Hornet-7-Comms/sauvc2022-acoustics/Firmware/stm32h750_acoustics/Docs/Clock Tree.png

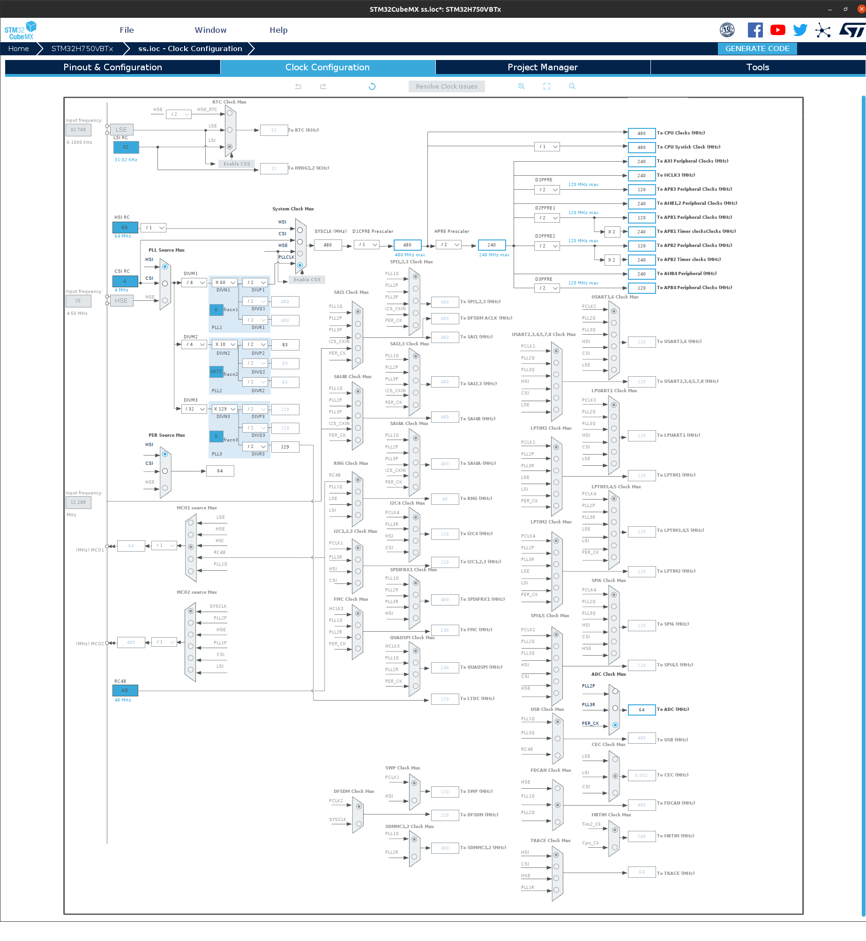
Firmware/stm32h750_acoustics/Docs/Clock Tree.png
