Hornet-7-Comms/sauvc2022-acoustics/Firmware/stm32h750_acoustics/Docs/Pinout.jpeg

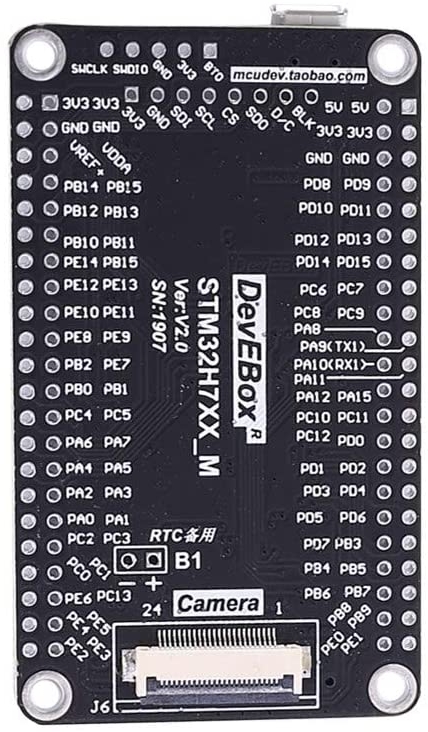
Firmware/stm32h750_acoustics/Docs/Pinout.jpeg
