Hornet-7-Comms/sauvc2022-acoustics/PCB/Acoustics ShopCart.xlsx

Qty | Mfr Part No | Unit Price (excl GST) | Line Price (excl GST) | Description | element14 link
50 | MC0805B104K250CT | 0.02 | 1 | 100nF C0805 | https://sg.element14.com/multicomp/mc0805b104k250ct/cap-0-1-f-25v-10-x7r-0805/dp/1759166 | x
50 | CL21B103KBANNNC | 0.054 | 2.7 | 10nF C0805 | https://sg.element14.com/samsung-electro-mechanics/cl21b103kbannnc/cap-0-01uf-50v-mlcc-0805/dp/3013470 | x
100 | MC0805B102K500CT | 0.027 | 2.7 | 1nF C0805 | https://sg.element14.com/multicomp/mc0805b102k500ct/cap-1000pf-50v-10-x7r-0805/dp/1759226 | x
40 | MCWR08X1503FTL | 0.006 | 0.24 | 150k R0805 | https://sg.element14.com/multicomp/mcwr08x1503ftl/res-150k-1-0-125w-thick-film/dp/2447573 | z | 0
50 | MCMR08X153 JTL | 0.008 | 0.4 | 15k R0805 | https://sg.element14.com/multicomp/mcmr08x153-jtl/res-15k-5-0-125w-0805-ceramic/dp/2073649 | z | 0
40 | MC01W080511K5 | 0.004 | 0.16 | 1k5 R0805 | https://sg.element14.com/multicomp/mc01w080511k5/res-1k5-1-0-1w-0805-thick-film/dp/9332600 |  | 0
40 | MCWR08X2200FTL | 0.006 | 0.24 | 220 R0805 | https://sg.element14.com/multicomp/mcwr08x2200ftl/res-220r-1-0-125w-0805-thick-film/dp/2447606 | y
50 | MCWR08X2201FTL | 0.006 | 0.3 | 2k2 R0805 | https://sg.element14.com/multicomp/mcwr08x2201ftl/res-2k2-1-0-125w-0805-thick-film/dp/2447623 | y
20 | MCMR08X8201FTL | 0.01 | 0.2 | 8k2 R0805 | https://sg.element14.com/multicomp/mcmr08x8201ftl/res-8k2-1-0-125w-0805-ceramic/dp/2073849 | z | 0
20 | MCWR08X4701FTL | 0.006 | 0.12 | 4k7 R0805 | https://sg.element14.com/multicomp/mcwr08x4701ftl/res-4k7-1-0-125w-0805-thick-film/dp/2447672 | y
50 | MCWR08X1001FTL | 0.006 | 0.3 | 1k R0805 | https://sg.element14.com/multicomp/mcwr08x1001ftl/res-1k-1-0-125w-0805-thick-film/dp/2447587 | y | 0
5 | BZV55-B5V1,115 | 0.282 | 1.41 | 5V1 Zener Mini-MELF | https://sg.element14.com/nexperia/bzv55-b5v1-115/diode-zener-5-1v-2-sod-80/dp/8735441 | y
20 | LL4148-7 | 0.025 | 0.5 | Signal diode Mini-MELF | https://sg.element14.com/multicomp/ll4148-13/diode-ultrafast-recovery-75v-minimelf/dp/2306145
 |  |  | Goods Total (excl GST)
 |  |  | 10.27
