Hornet-7-Comms/sauvc2022-acoustics/Firmware/teensy_sketch_dec09b/Teensy Sch/parts_placement_teensy36_top.png

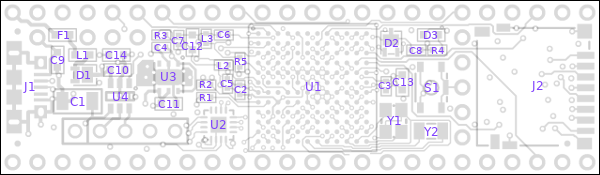
Firmware/teensy_sketch_dec09b/Teensy Sch/parts_placement_teensy36_top.png
