Hornet-7-Comms/sauvc2022-acoustics/PCB/Acoustics Soldering Guide.pptx

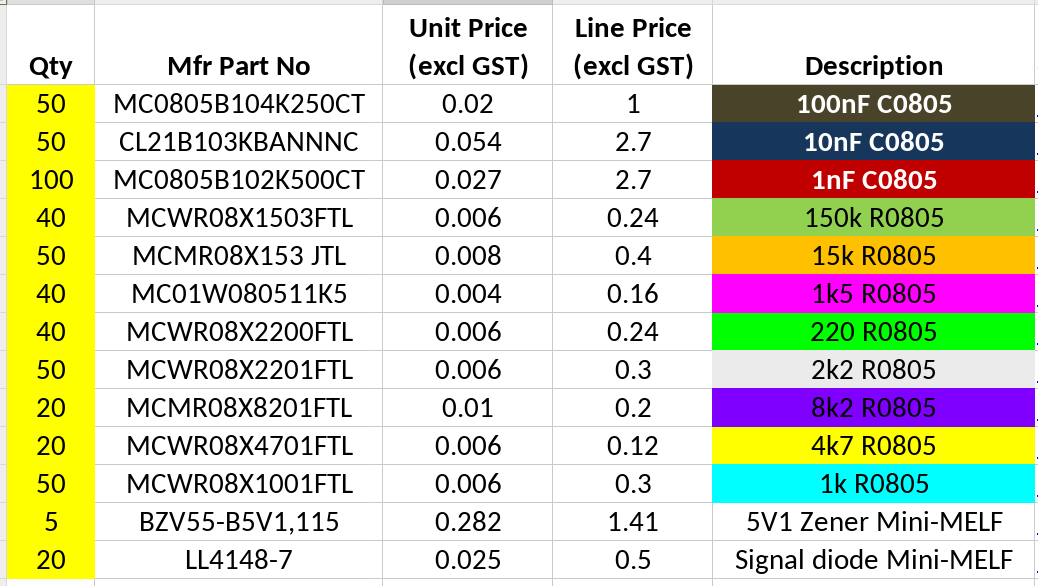
[picture p8: figure]

## Slide 2

100n

10n

1n

?

100n

10n

1n

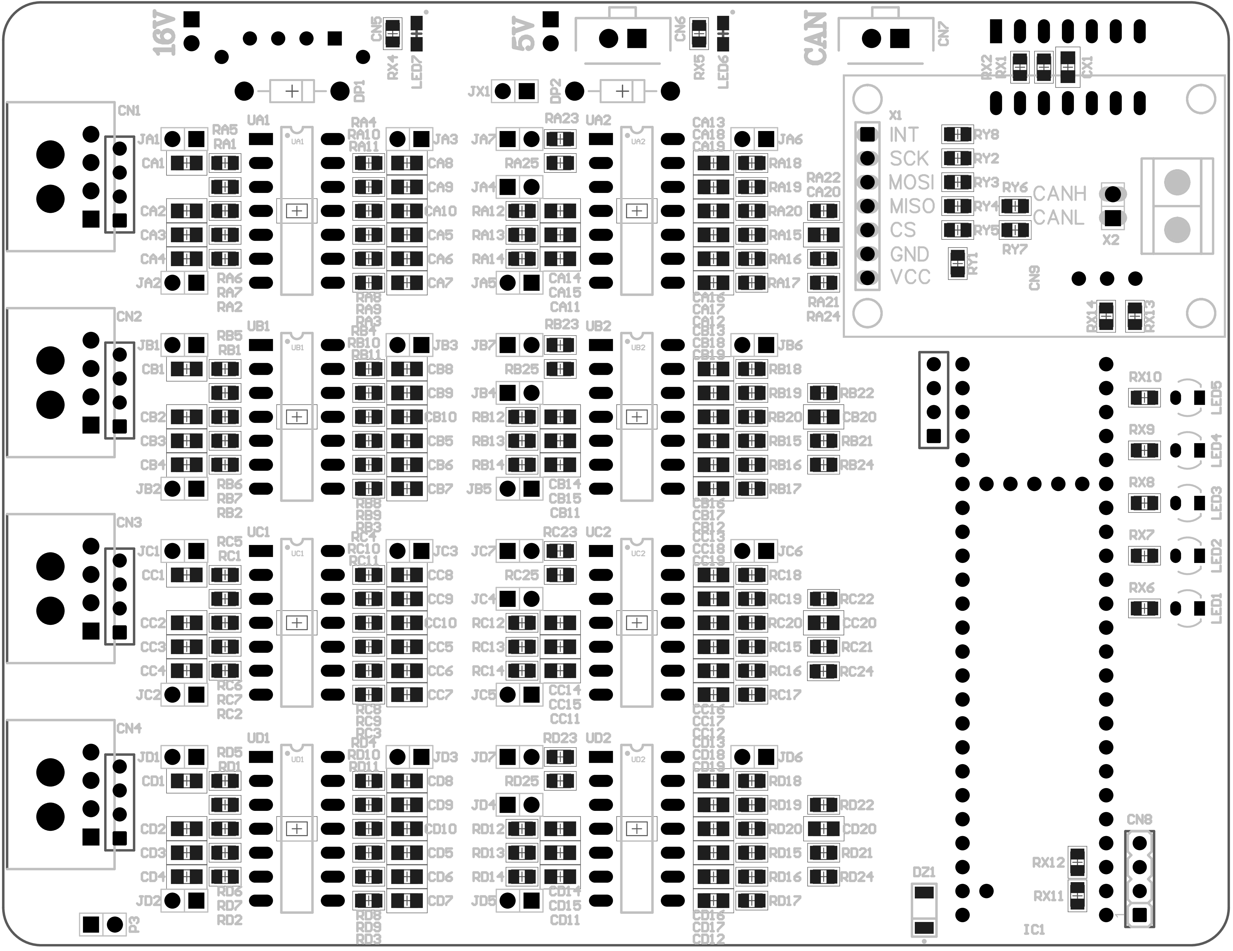
[picture p9: figure]

4k7

1k

150k

150k

100n

100n

150k

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
150k

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
100n

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
150k

150k

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
## Slide 3

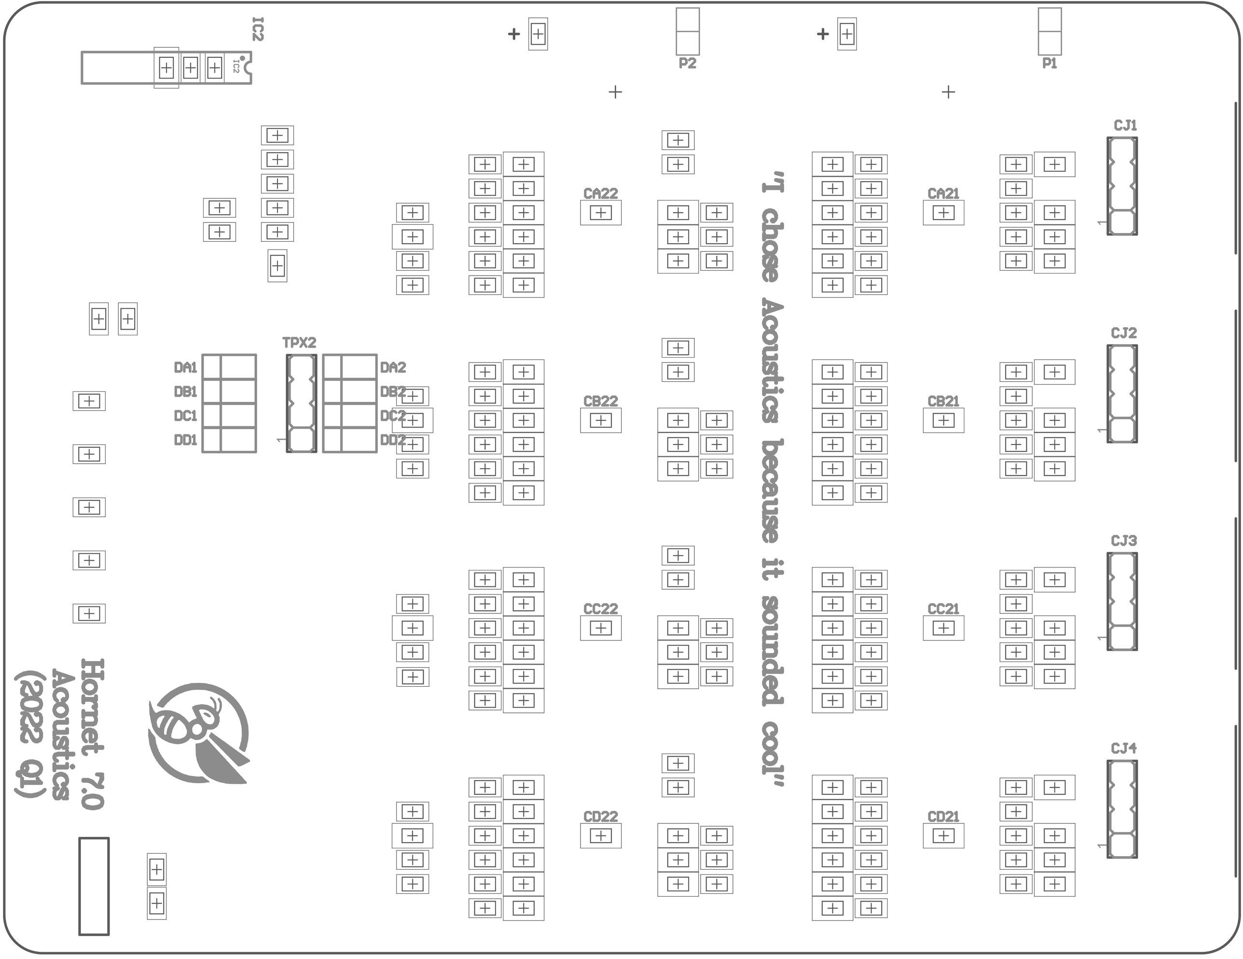
[picture p10: figure]

100n

100n

Z

Z
