Hornet-7-Comms/sauvc2022-acoustics/PCB/Acoustics Schematic.pdf

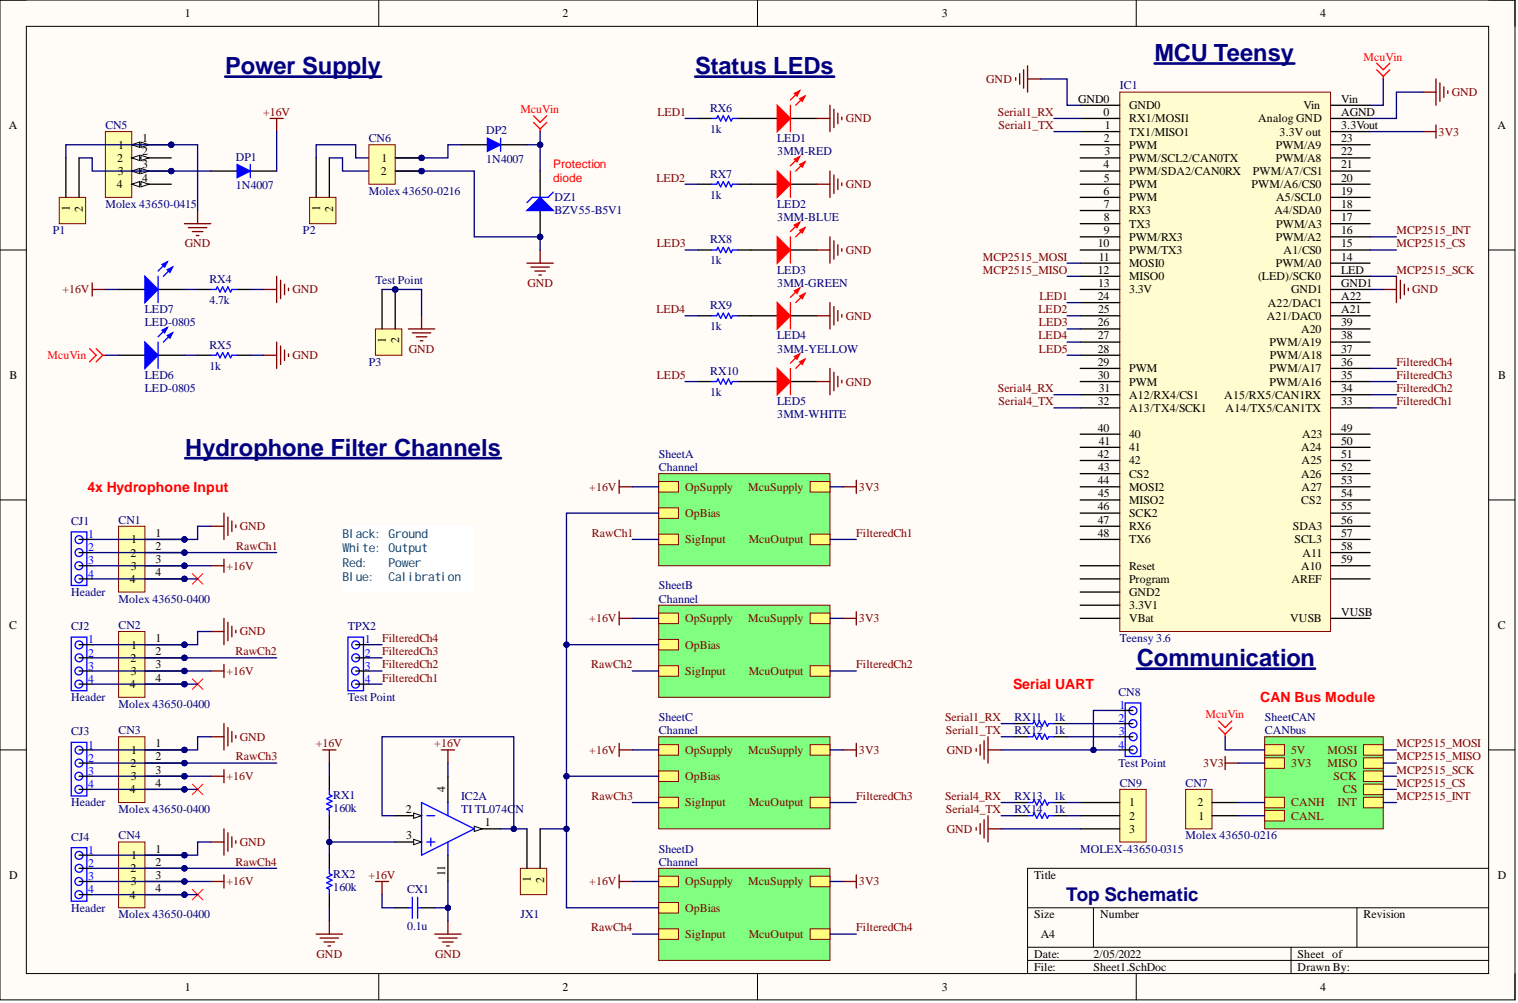
[picture p11: page 1]
4 PWM/A16; 35 PWM/A17; 36 PWM/A18; 37 PWM/A19; 39 A21/DAC0; 1 (LED)/SCK0; LED PWM/A0; 15 PWM/A2; 16 PWM/A3; 17 A4/SDA0; 18 A5/SCL0; 19 PWM/A6/CS0; 20 PWM/A7/CS1; 21 PWM/A8; 22 PWM/A9; 23 3.3V out; 3.3Vou; IC1 Teen; Power Supply; diode DZ1; Top Schematic; Status LEDs; CAN Bus M; Serial UART

Hydrophone Filter Channels

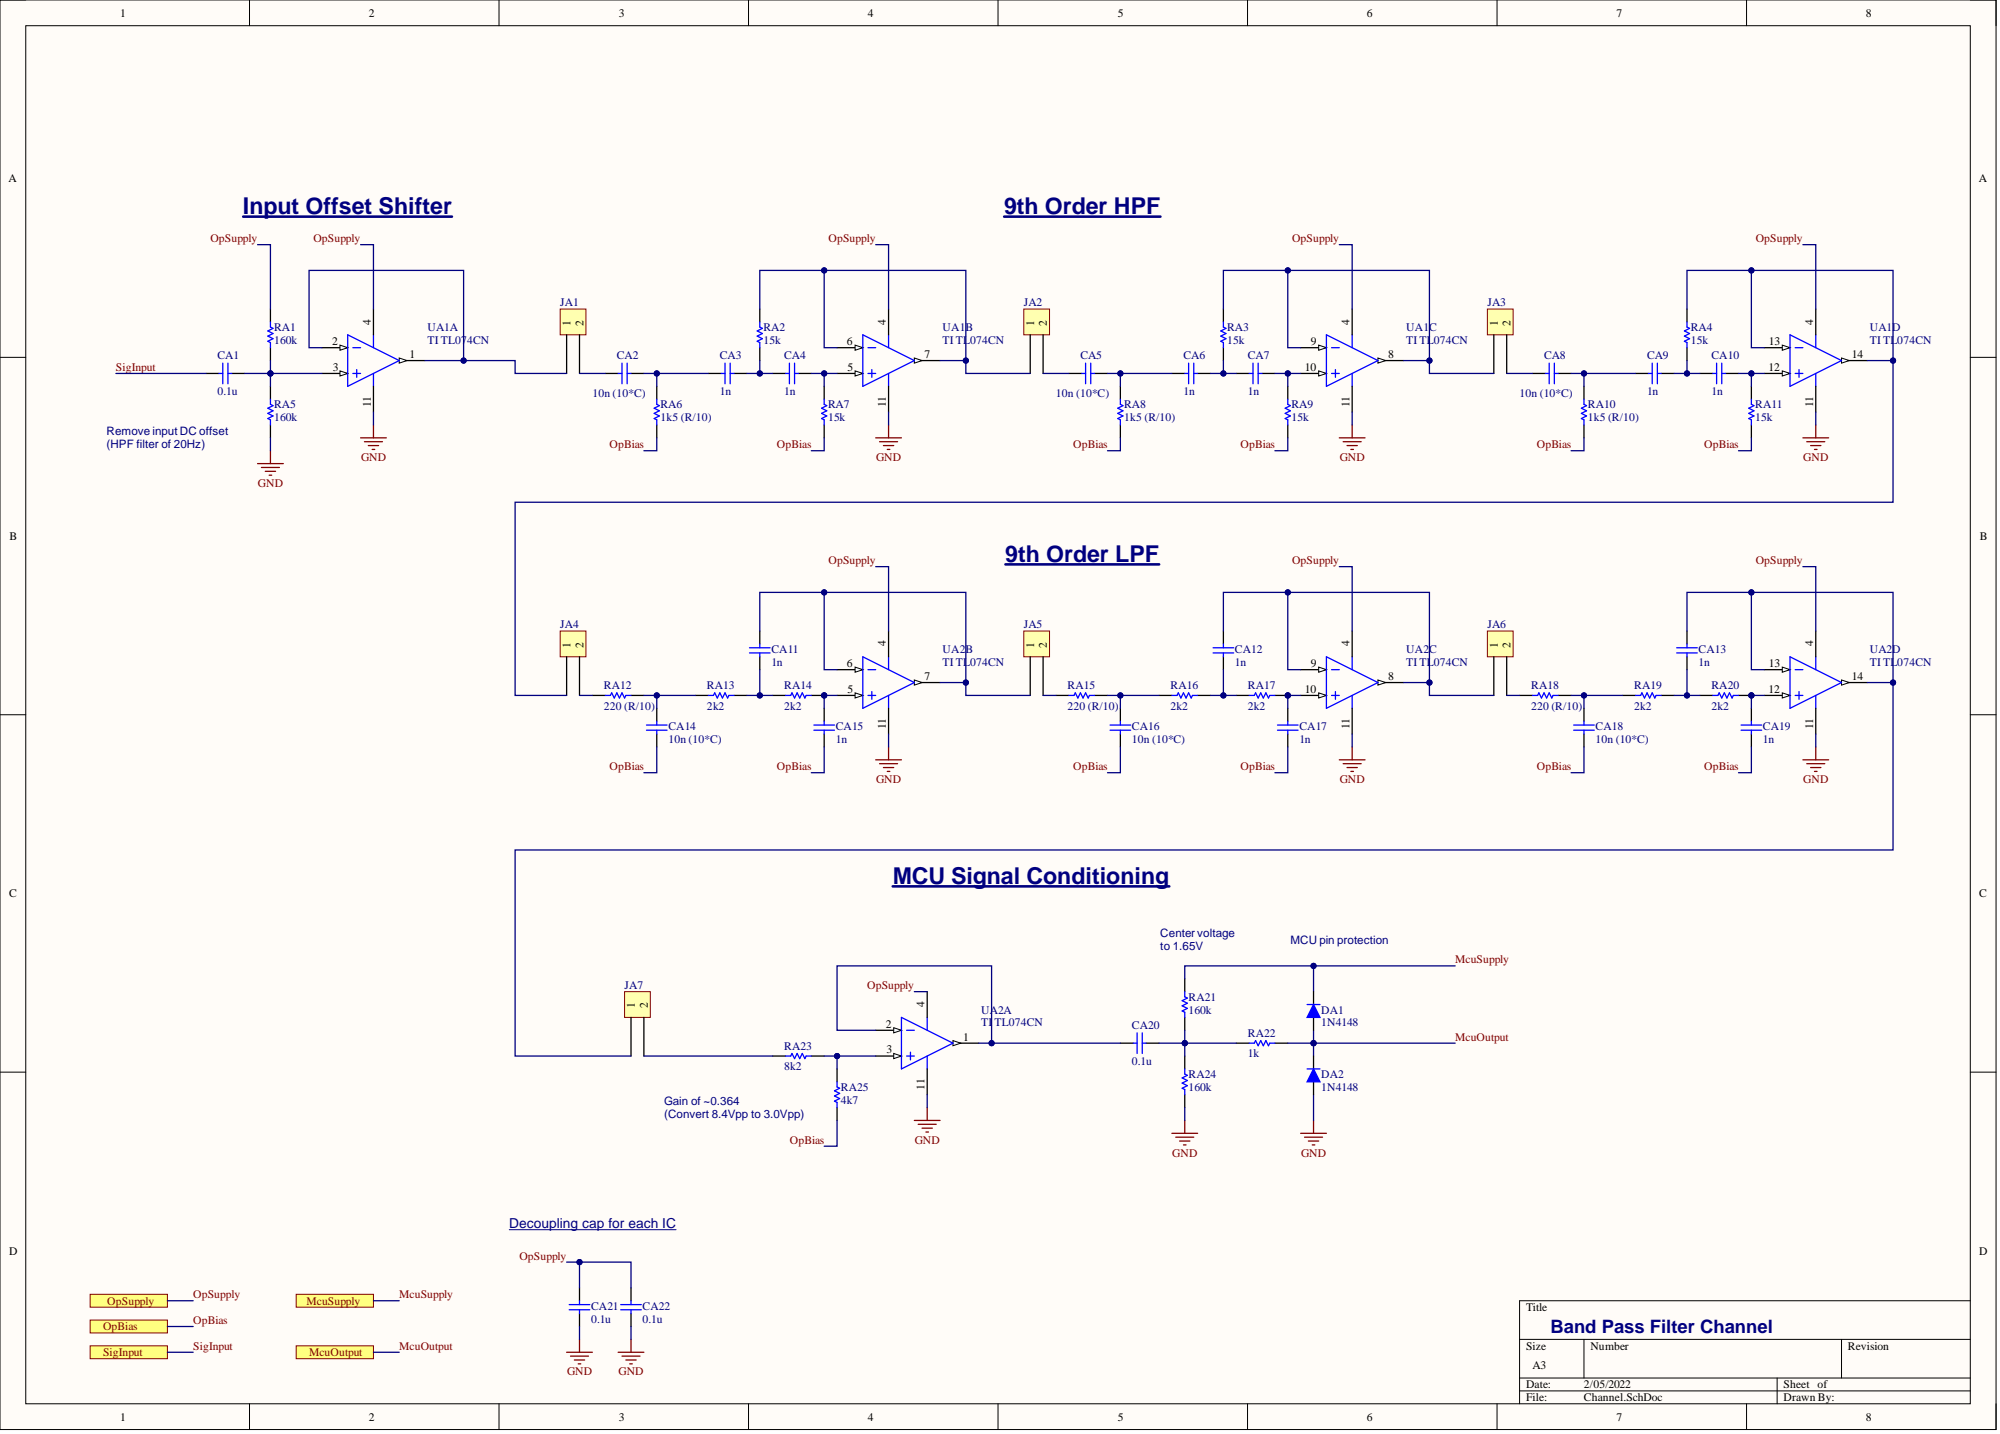
[picture p12: page 2]
Date:; Sheet of; File:; Channel.SchDoc; Drawn By:; 9th Order HPF; 9th Order LPF; Gain of ~0.364 (Convert 8.4Vpp to 3.0Vpp); Center voltage; MCU pin protection; PICA1402 COC14; PICA1502 COC15; PICA1602 COC16; PICA1702 COC17; PICA1802 COC18; PICA1902 COC19; PIDA10K COD1; PIDA20K COD2; PIJA101 PIJA102; PIJA201 PIJA202; PIJA301 PIJA302; PIJA401 PIJA402; PIJA501 PIJA502; PIJA601 PIJA602; PIJA701 PIJA702; PIRA102 COR1; PIRA202 COR2; PIRA302 COR3; PIRA402 COR4; PIRA502 COR5; PIRA602 COR6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

Input Offset Shifter

Remove input DC offset
(HPF filter of 20Hz)

MCU Signal Conditioning

Decoupling cap for each IC

Title
Band Pass Filter Channel

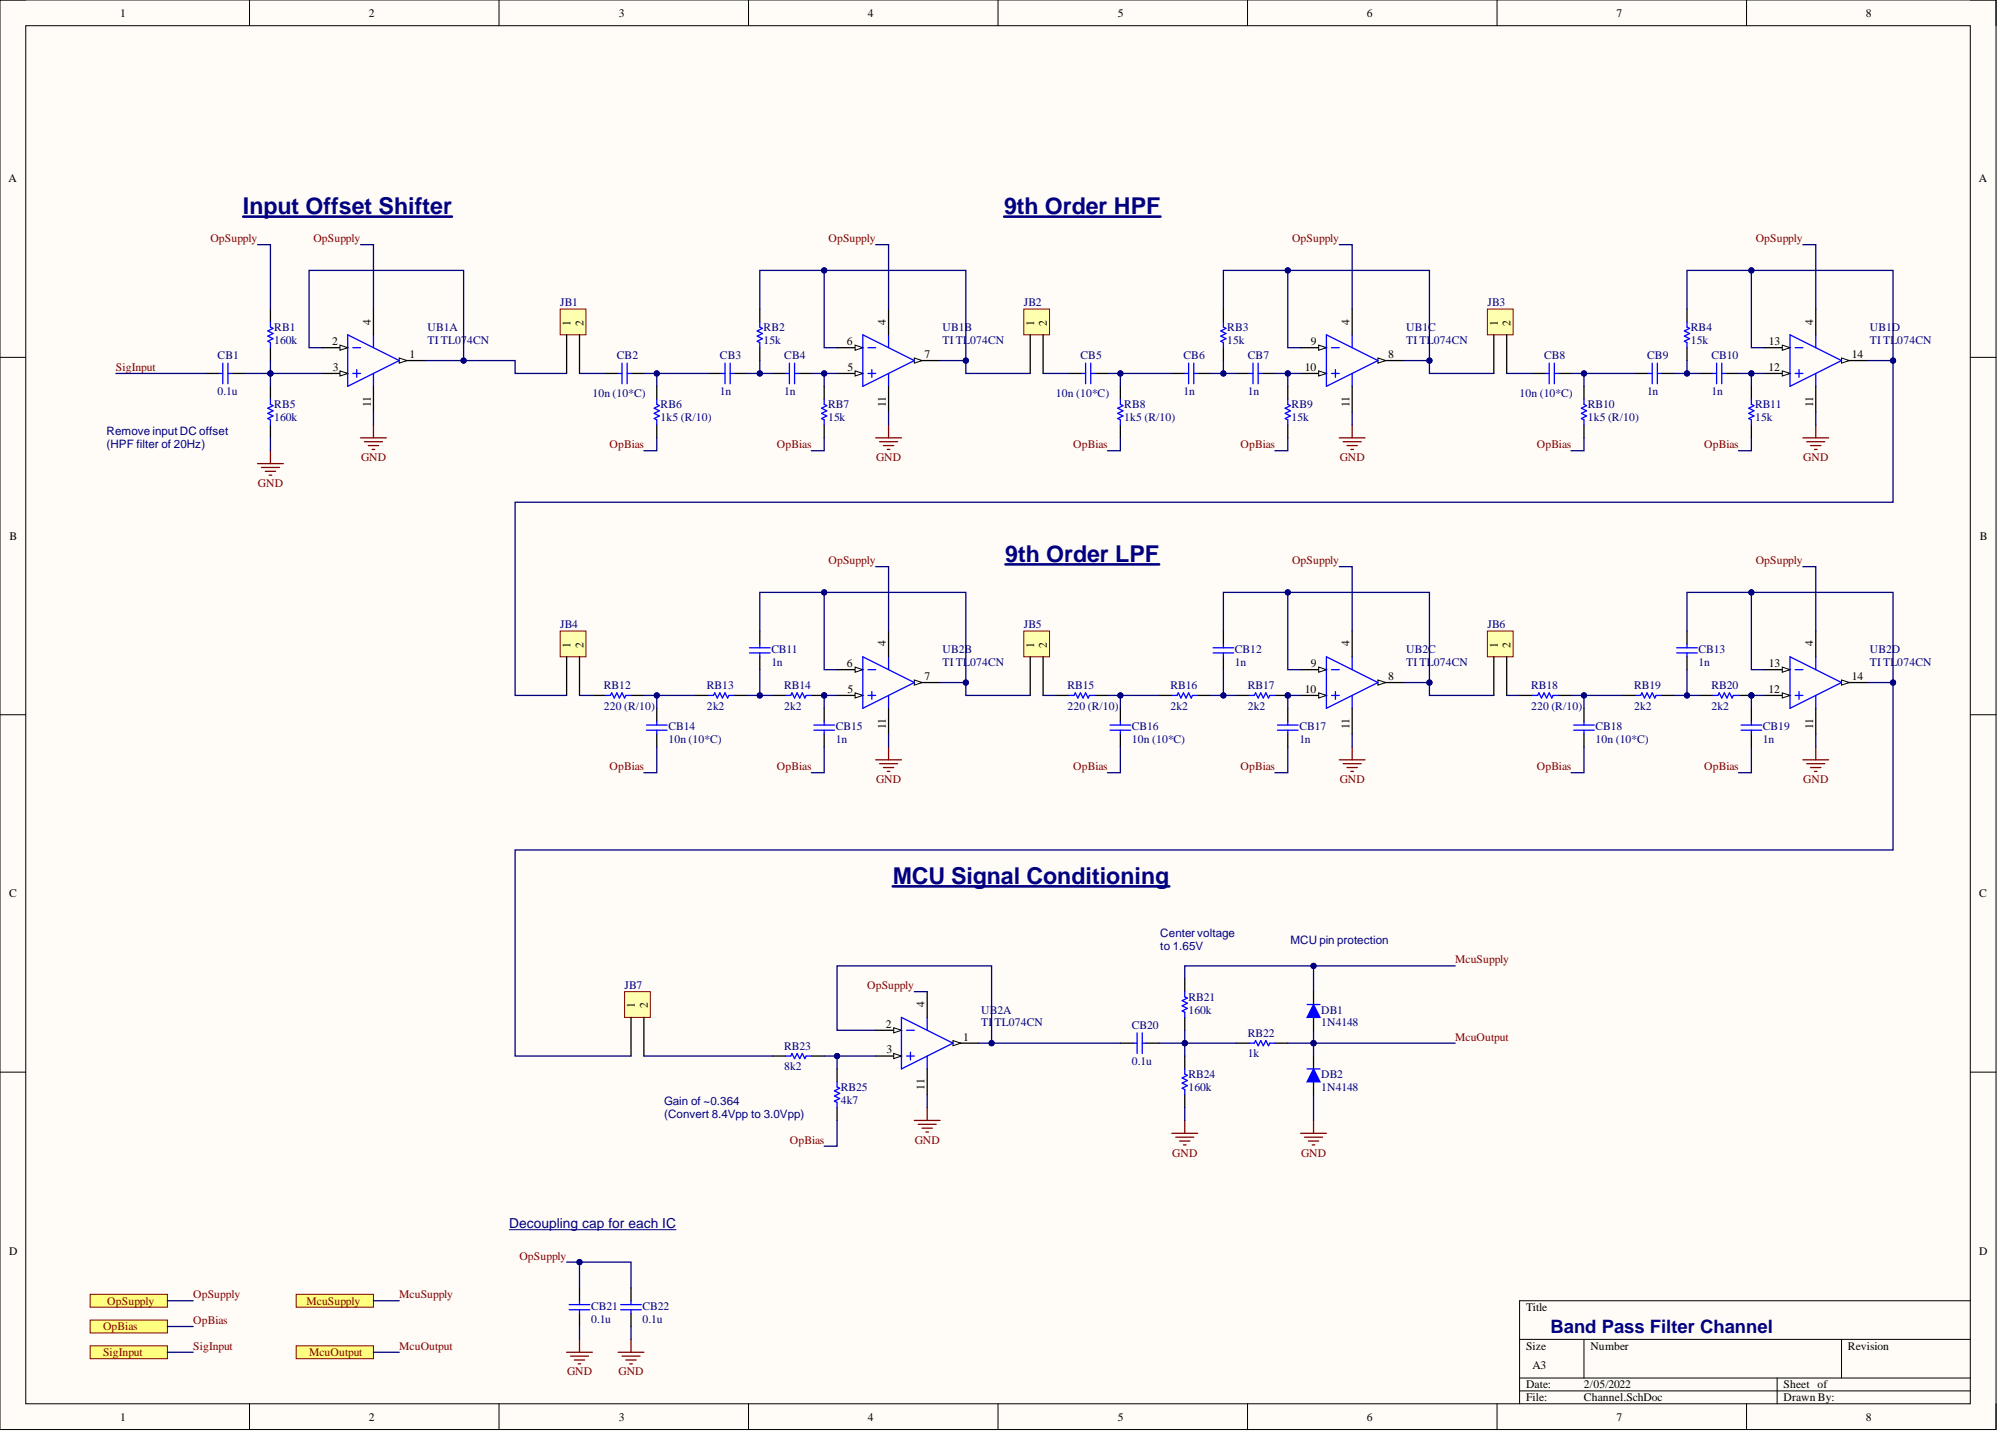
[picture p13: page 3]
9th Order HPF; 9th Order LPF; Gain of ~0.364 (Convert 8.4Vpp to 3.0Vpp); Center voltage; MCU pin protection; PICB1402 COC14; PICB1502 COC15; PICB1602 COC16; PICB1702 COC17; PICB1802 COC18; PICB1902 COC19; PIDB10K COD1; PIDB20K COD2; PIJB101 PIJB102; PIJB201 PIJB202; PIJB301 PIJB302; PIJB401 PIJB402; PIJB501 PIJB502; PIJB601 PIJB602; PIJB701 PIJB702; PIRB102 COR1; PIRB202 COR2; PIRB302 COR3; PIRB402 COR4; PIRB502 COR5; PIRB602 COR6; PIRB702 COR7; PIRB802 COR8; PIRB902 COR9; PIRB1002 COR10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

Input Offset Shifter

Remove input DC offset
(HPF filter of 20Hz)

MCU Signal Conditioning

Decoupling cap for each IC

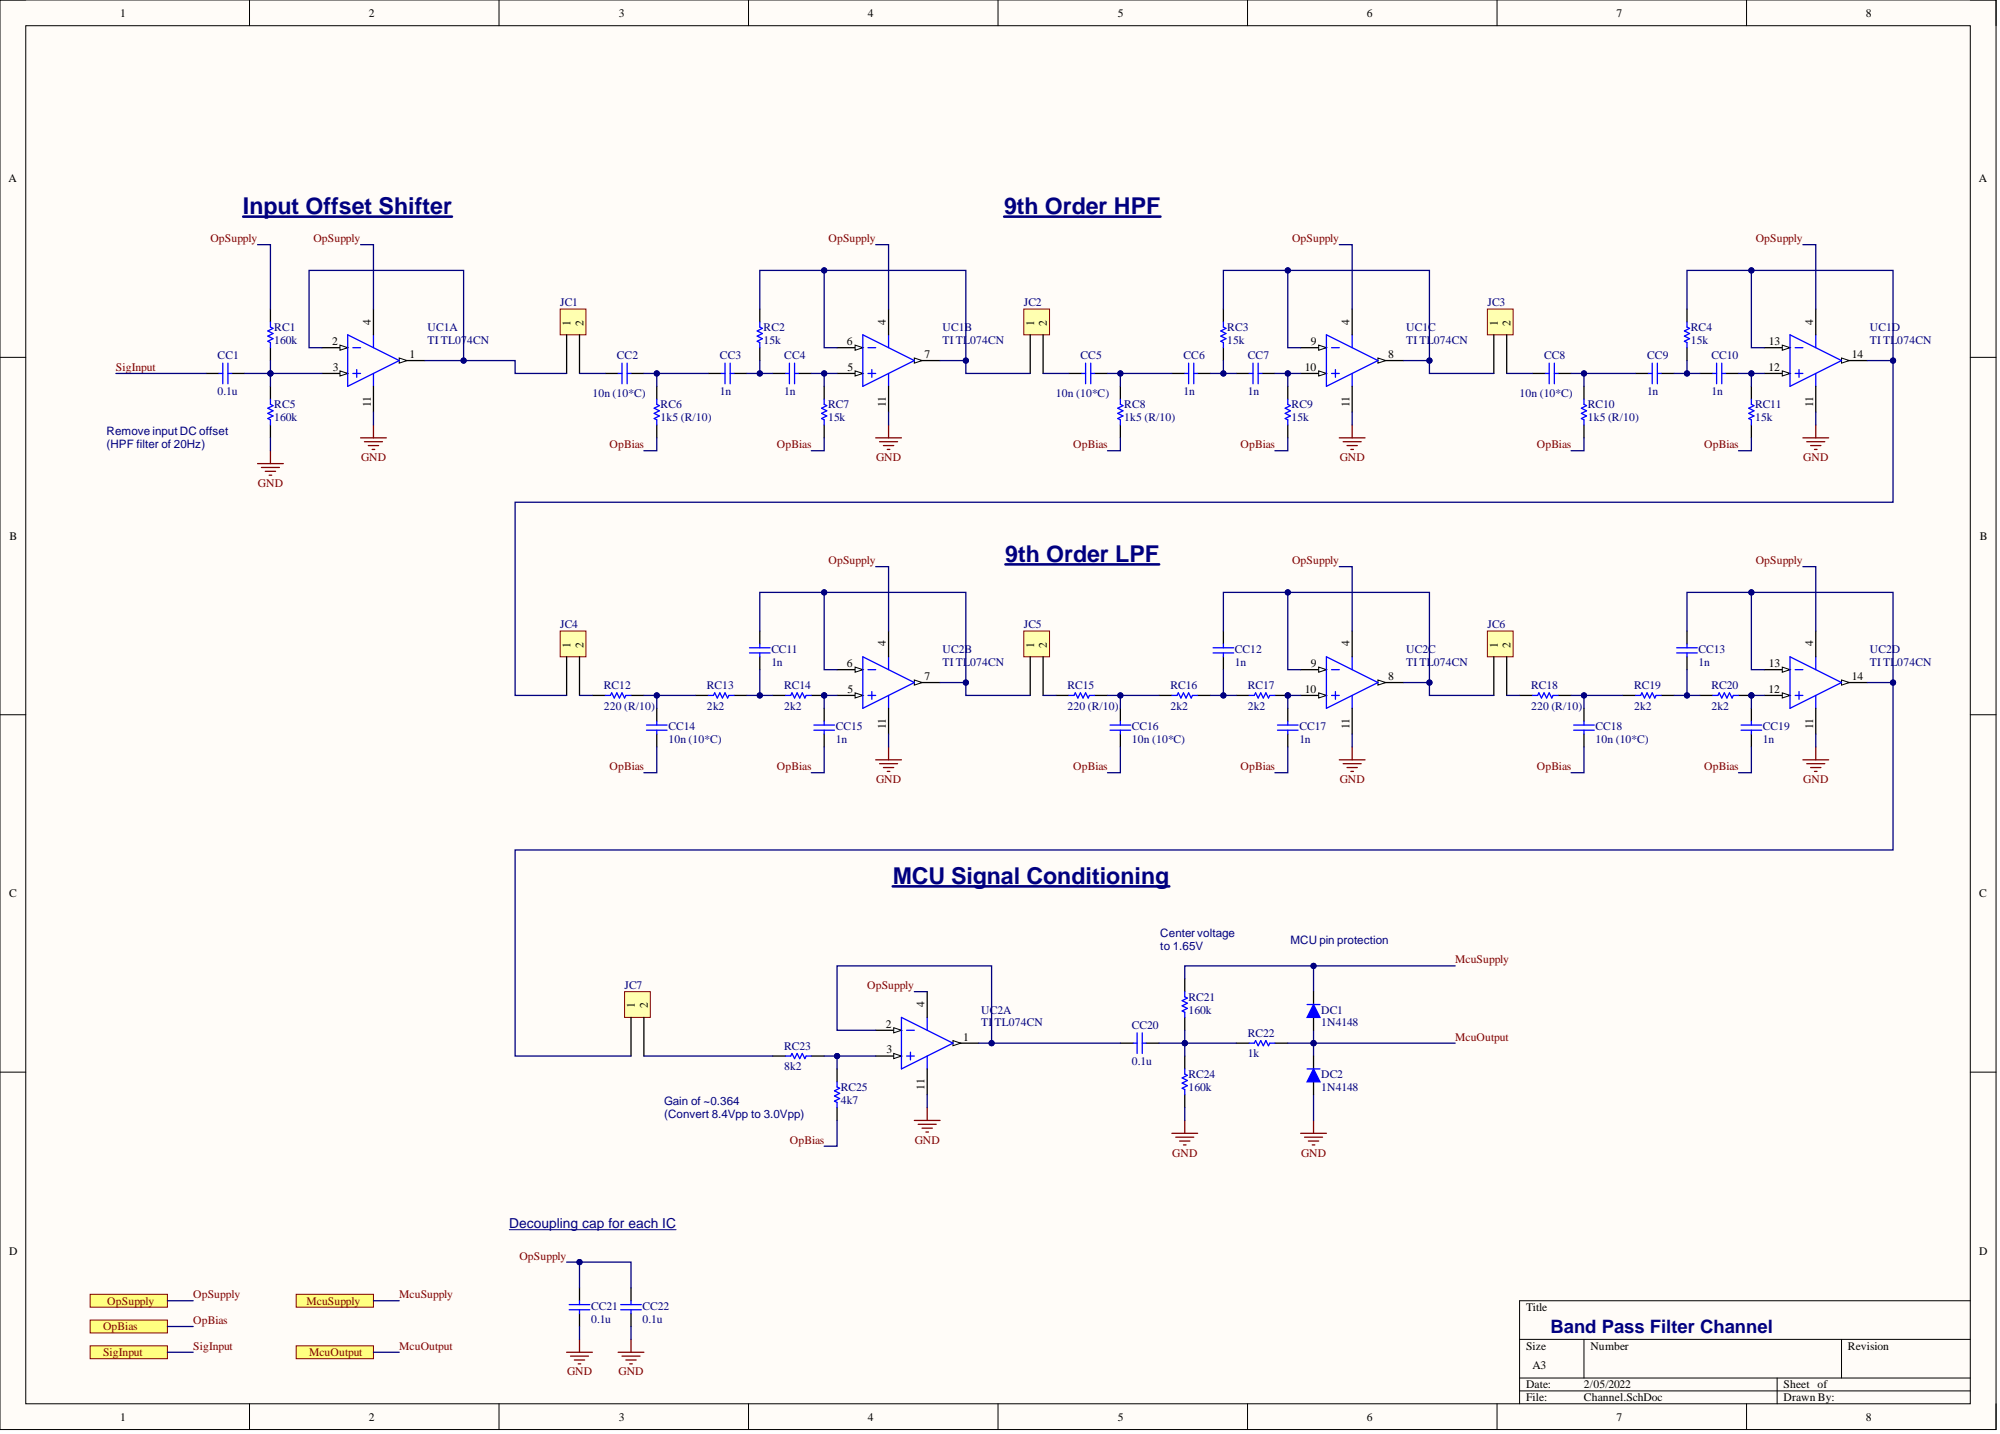
[picture p14: page 4]
9th Order HPF; 9th Order LPF; Gain of ~0.364 (Convert 8.4Vpp to 3.0Vpp); Center voltage; MCU pin protection; PICC1402 COC14; PICC1502 COC15; PICC1602 COC16; PICC1702 COC17; PICC1802 COC18; PICC1902 COC19; PIDC10K COD1; PIDC20K COD2; PIJC101 PIJC102; PIJC201 PIJC202; PIJC301 PIJC302; PIJC401 PIJC402; PIJC501 PIJC502; PIJC601 PIJC602; PIJC701 PIJC702; PIRC102 COR1; PIRC202 COR2; PIRC302 COR3; PIRC402 COR4; PIRC502 COR5; PIRC602 COR6; PIRC702 COR7; PIRC802 COR8; PIRC902 COR9; PIRC1002 COR10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

Input Offset Shifter

Remove input DC offset
(HPF filter of 20Hz)

MCU Signal Conditioning

Decoupling cap for each IC

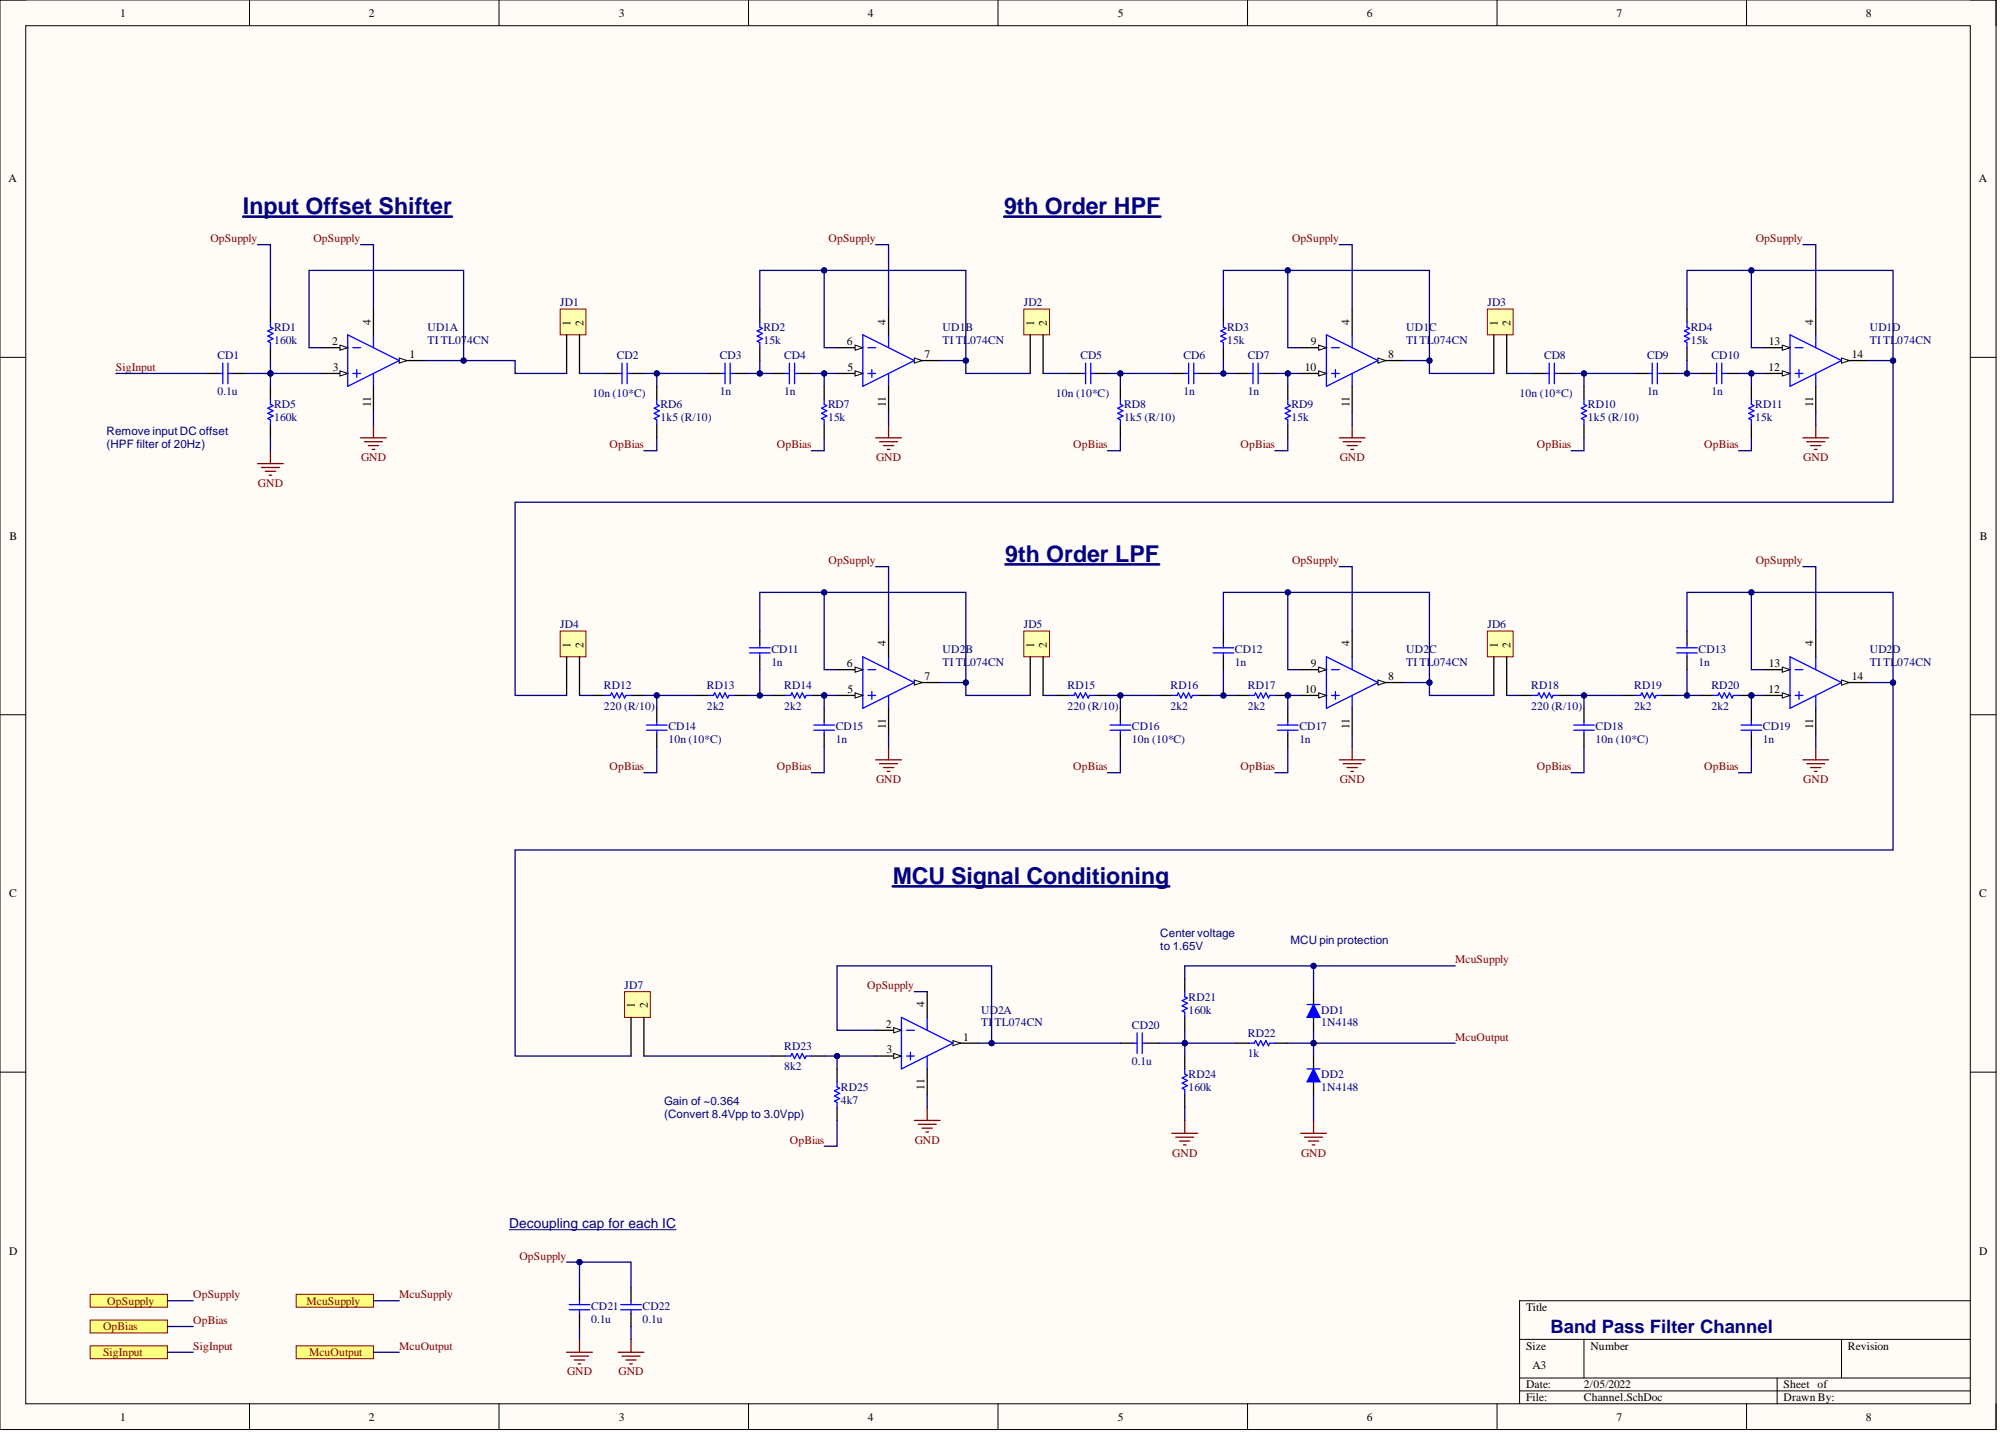
[picture p15: page 5]
9th Order HPF; 9th Order LPF; Gain of ~0.364 (Convert 8.4Vpp to 3.0Vpp); Center voltage; MCU pin protection; PICD1402 COC14; PICD1502 COC15; PICD1602 COC16; PICD1702 COC17; PICD1802 COC18; PICD1902 COC19; PIDD10K COD1; PIDD20K COD2; PIJD101 PIJD102; PIJD201 PIJD202; PIJD301 PIJD302; PIJD401 PIJD402; PIJD501 PIJD502; PIJD601 PIJD602; PIJD701 PIJD702; PIRD102 COR1; PIRD202 COR2; PIRD302 COR3; PIRD402 COR4; PIRD502 COR5; PIRD602 COR6; PIRD702 COR7; PIRD802 COR8; PIRD902 COR9; PIRD1002 COR10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

Input Offset Shifter

Remove input DC offset
(HPF filter of 20Hz)

MCU Signal Conditioning

Decoupling cap for each IC

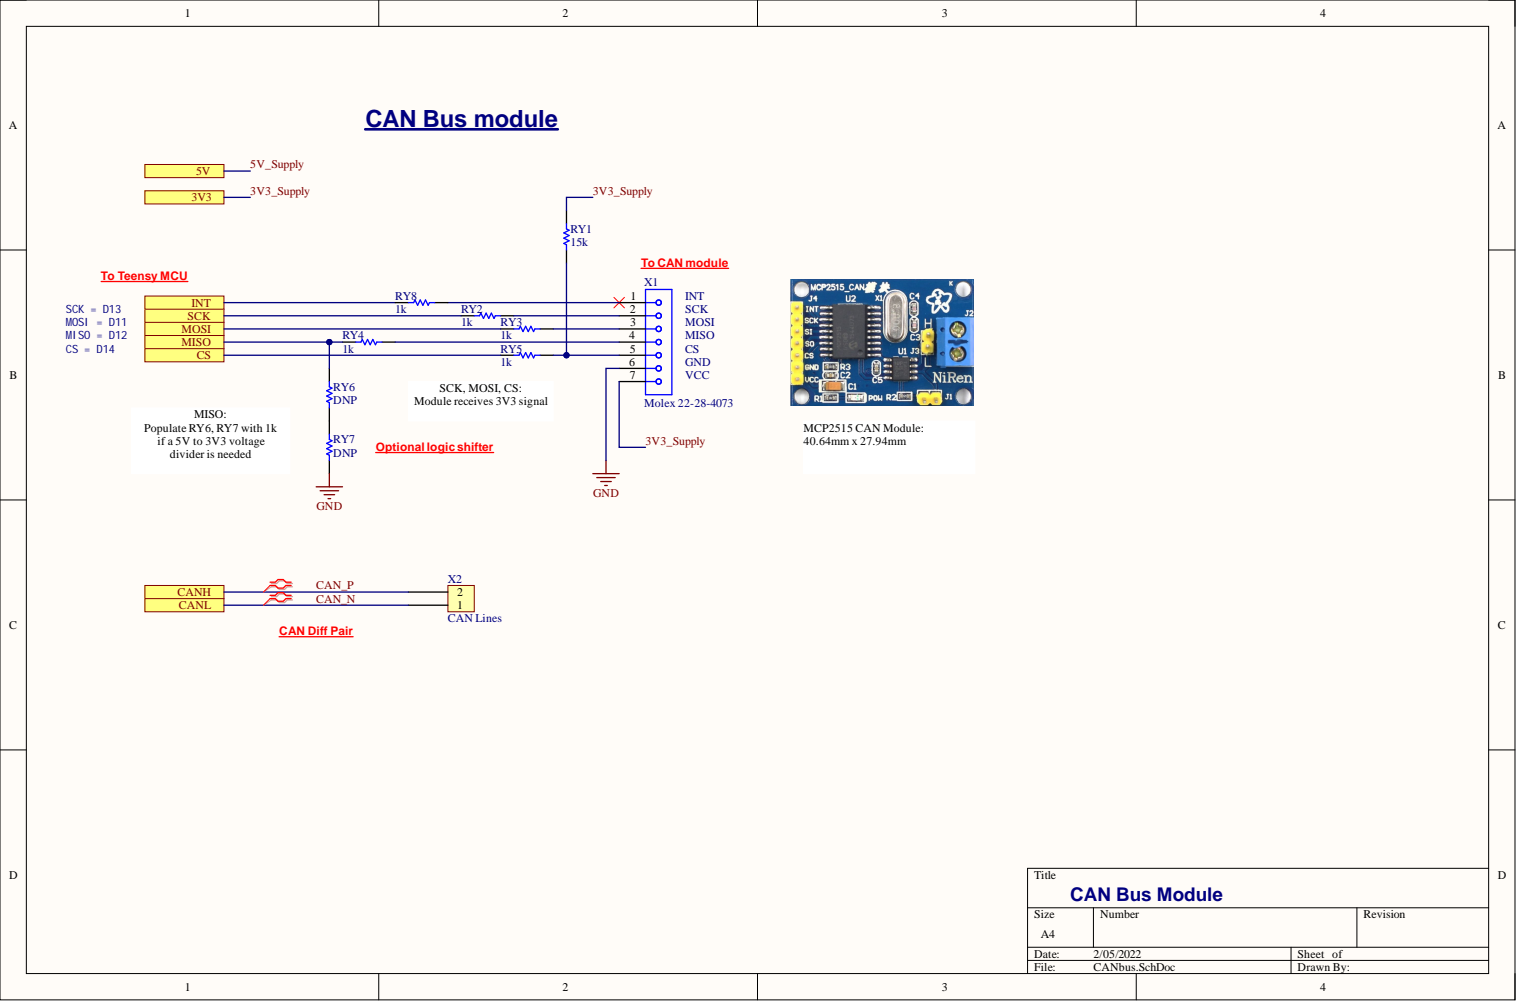
[picture p16: page 6]
File:; CANbus.SchDoc; Drawn By:; Molex 22-28-4073; To CAN module; MOSI = D11 MISO = D12 CS = D14; SCK = D13; MCP2515 CAN Module: 40.64mm x 27.94mm; CAN Lines

CAN Bus module

To Teensy MCU

SCK, MOSI, CS:
Module receives 3V3 signal

Populate RY6, RY7 with 1k
if a 5V to 3V3 voltage
divider is needed

3V3_Supply Optional logic shifter

CAN Diff Pair

Title
CAN Bus Module
