Hornet-7-Comms/sauvc2022-acoustics/PCB/Acoustics Assembly Drawings.pdf

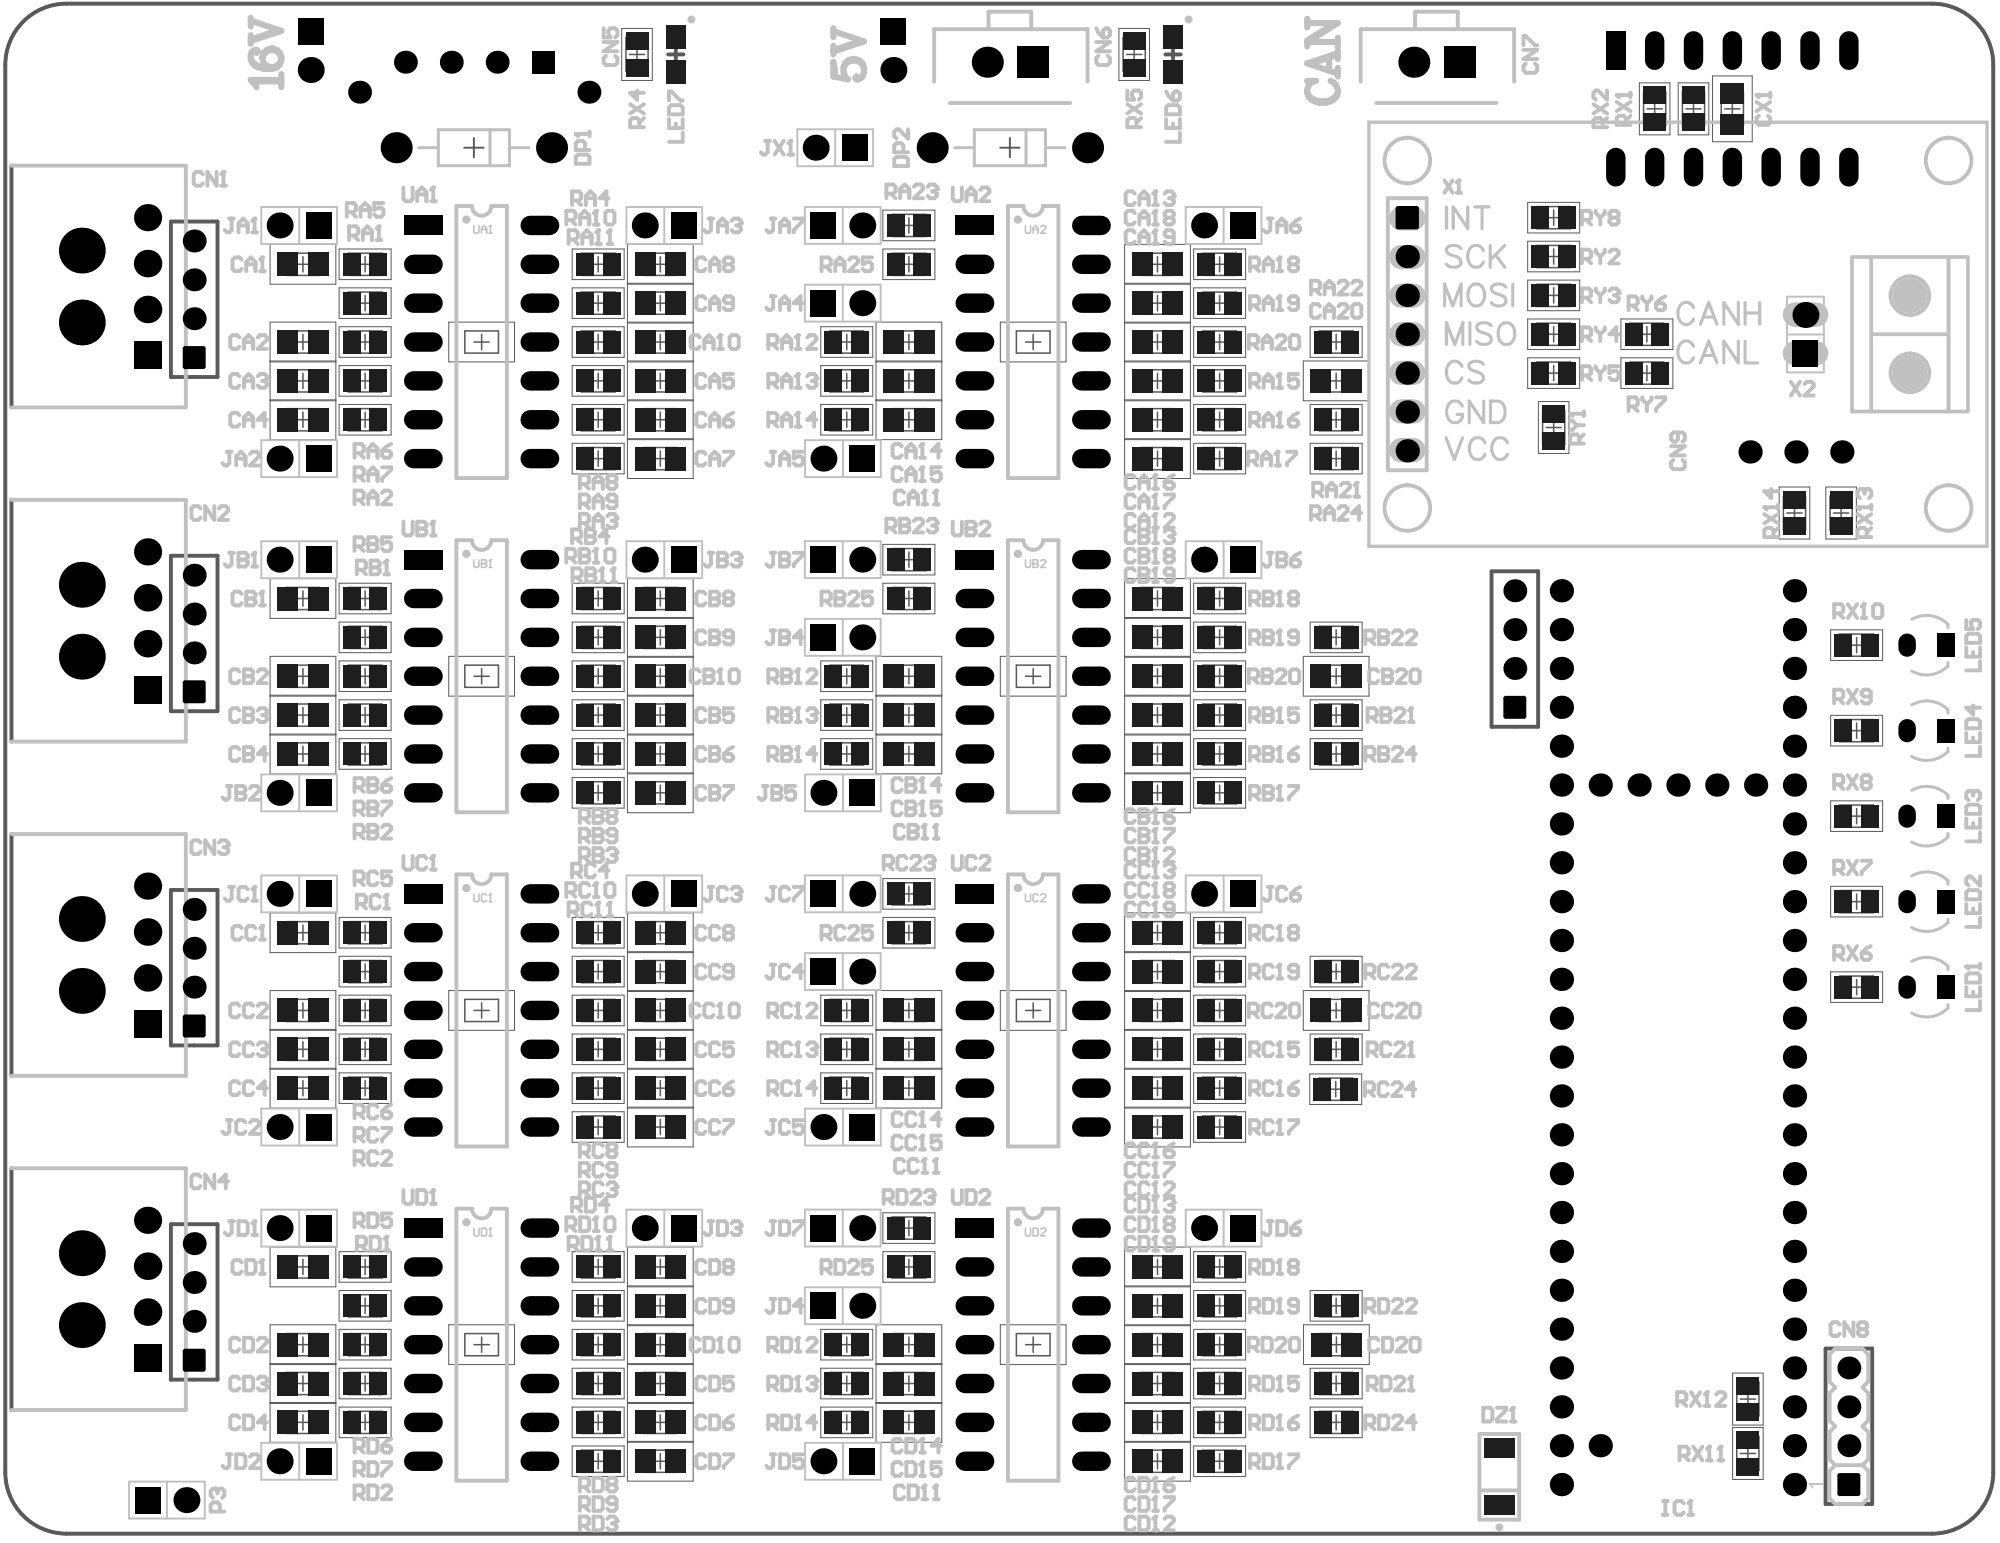
[picture p17: page 1]

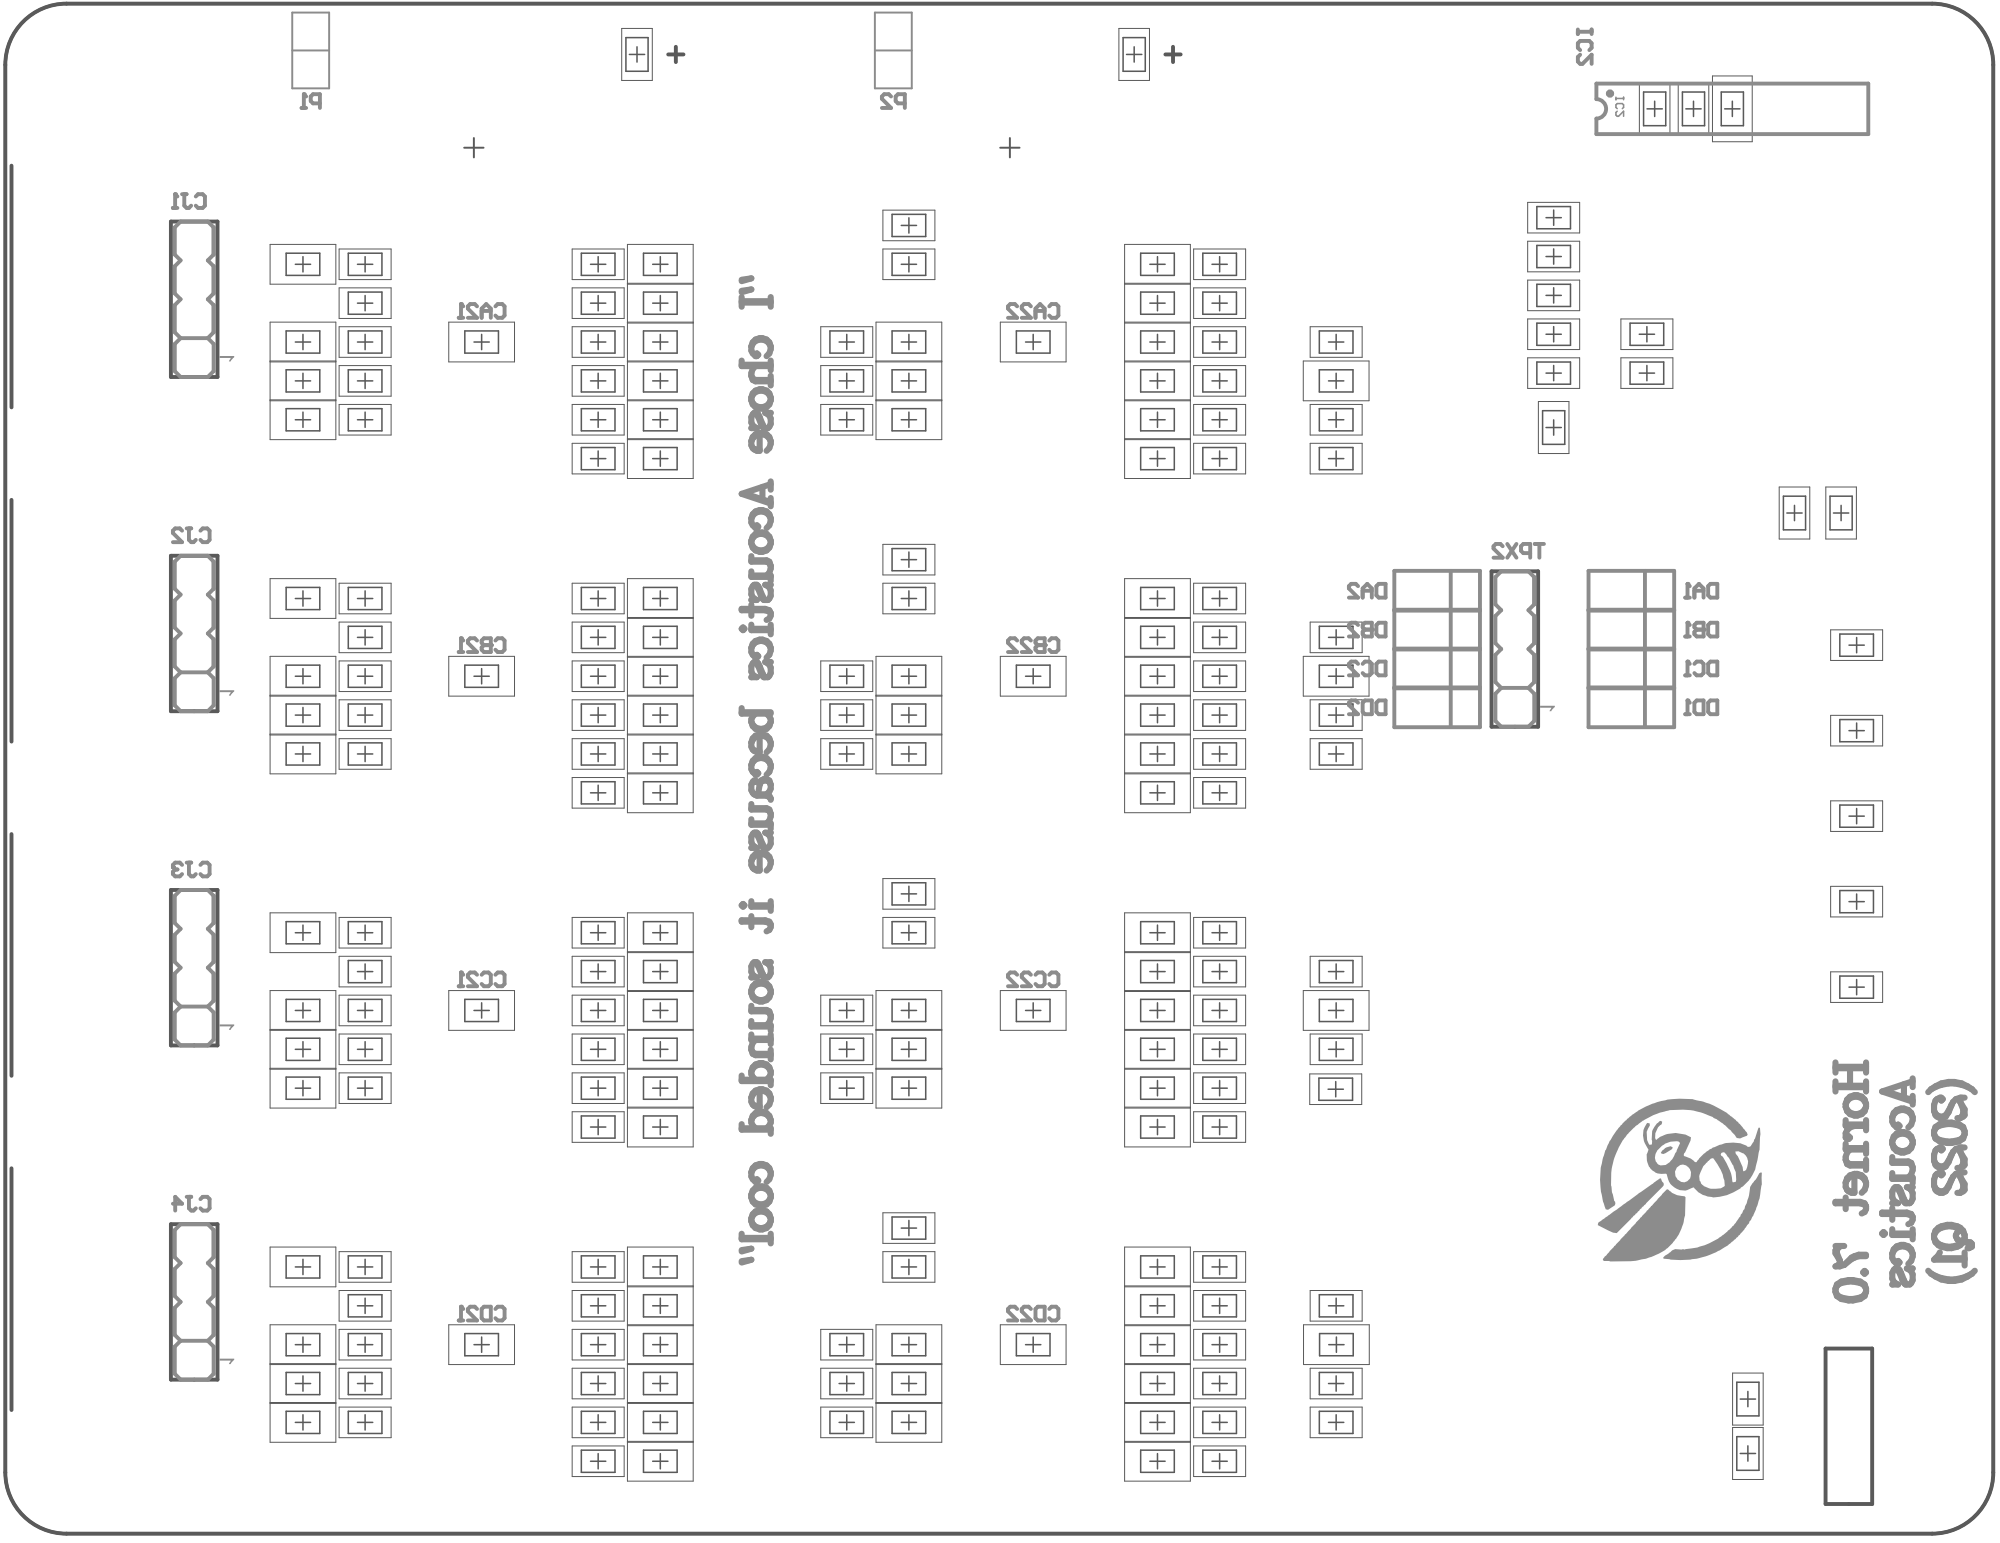
[picture p18: page 2]

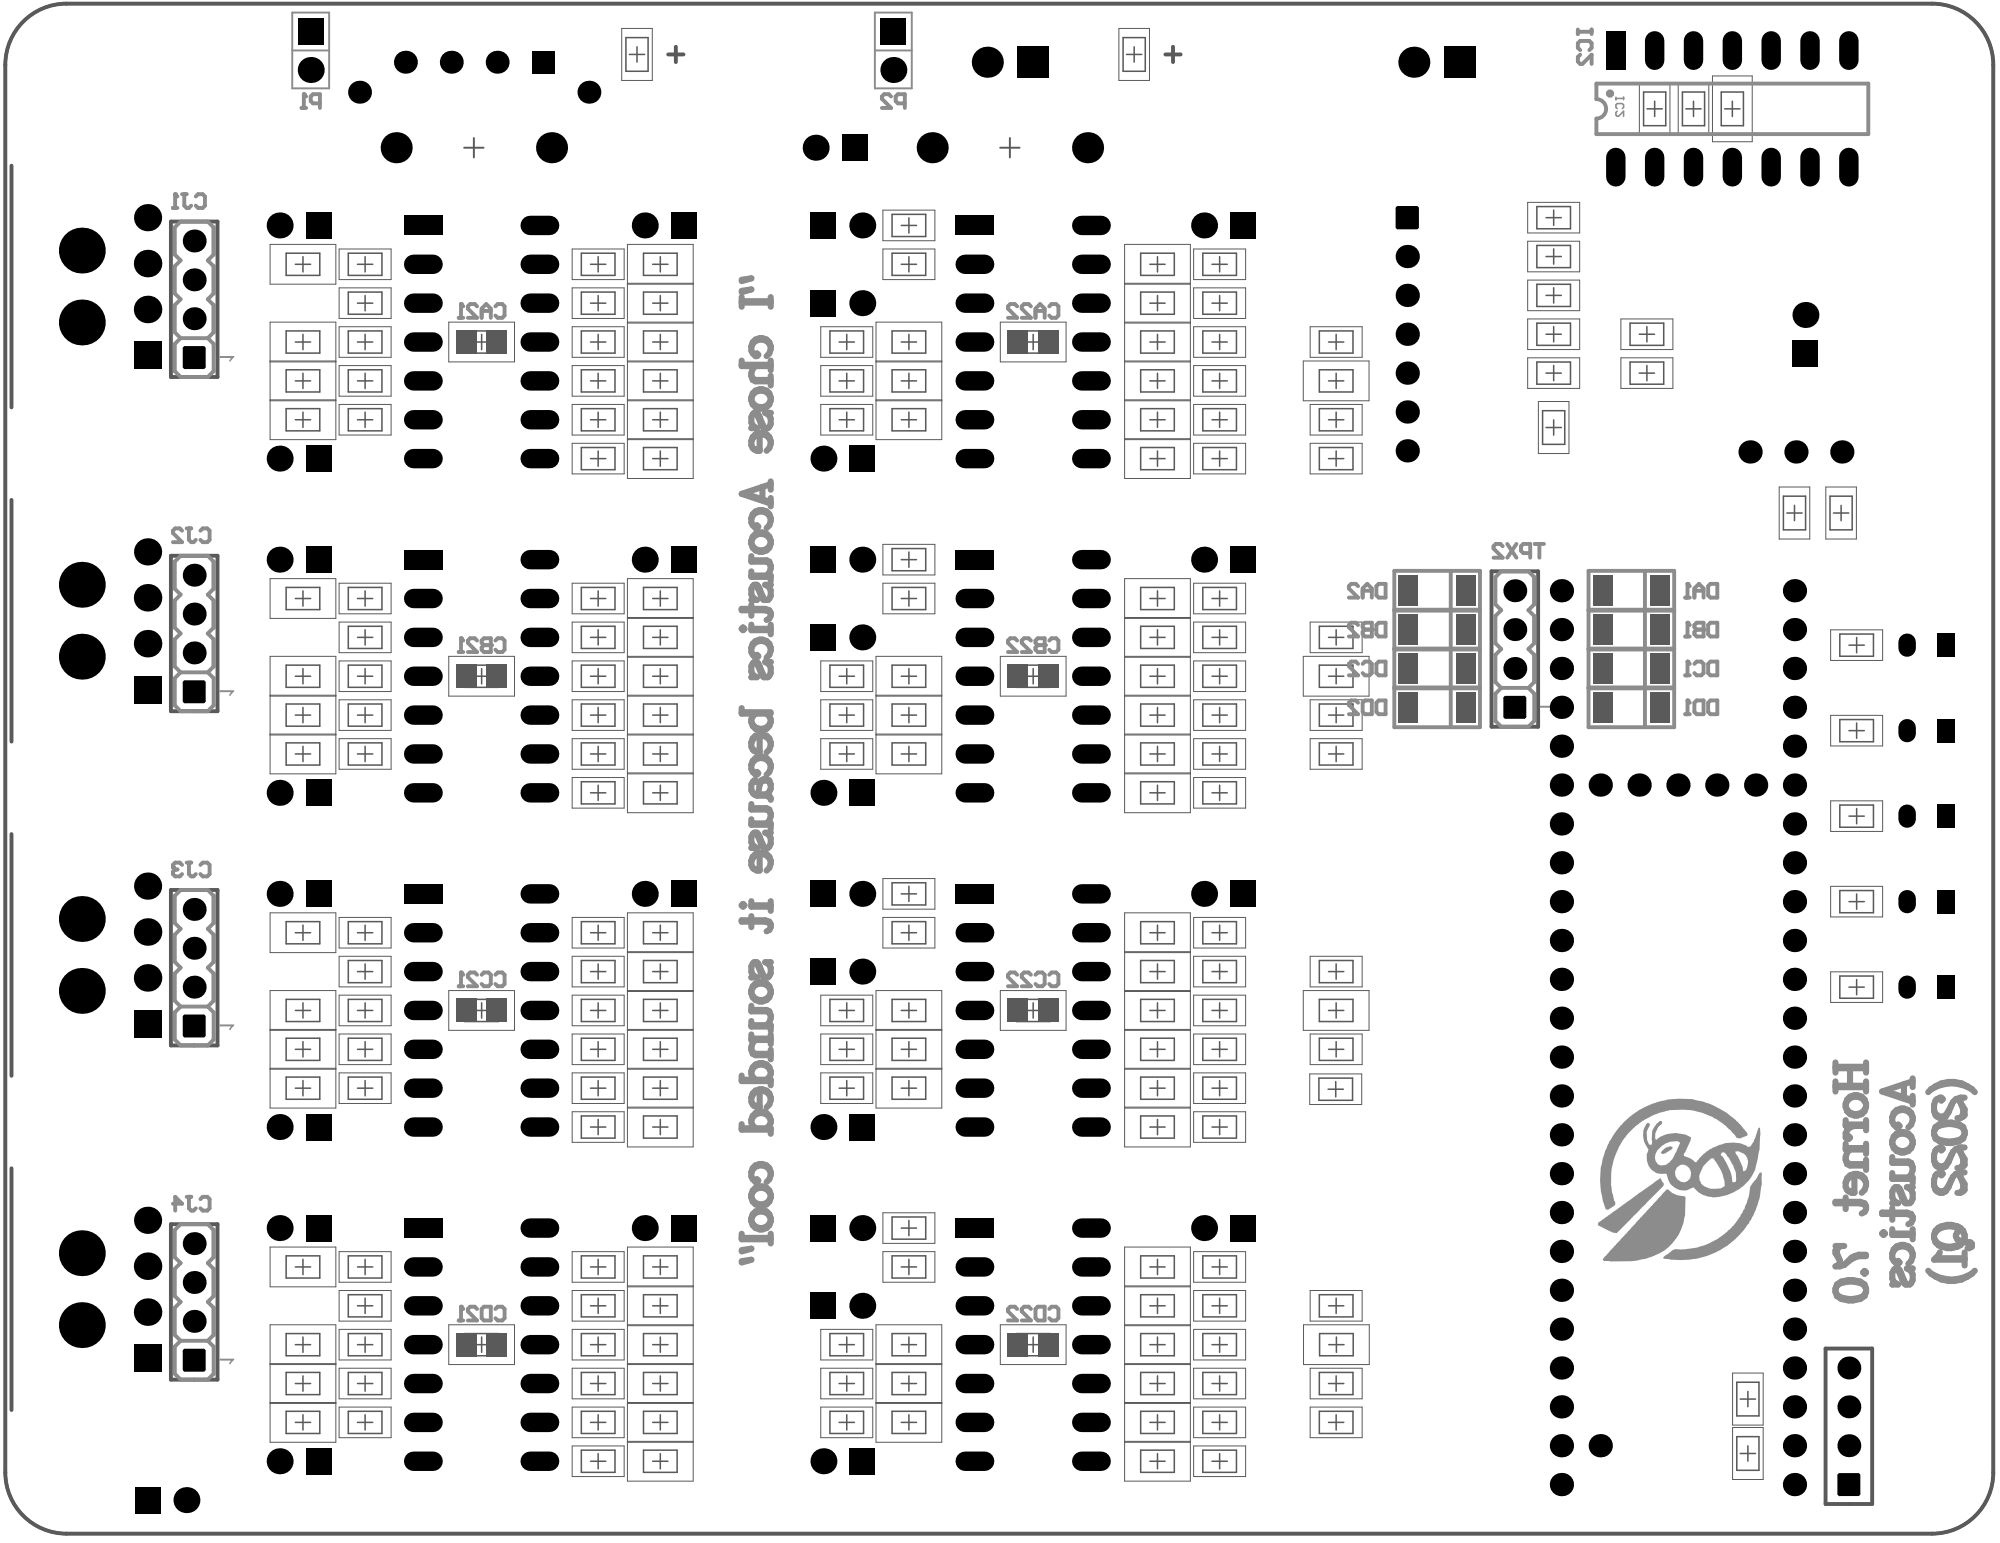
[picture p19: page 4]
