Hornet-7-Comms/sauvc2022-acoustics/(commit log)

2022-06-13 Hardware PCB Design
    [Acoustics BOM.csv, Acoustics ShopCart.xlsx]
2022-06-28 Check for amplitude threshold to reduce likelihood of noise
    [stm32h750_acoustics.ino]
